OpenInstrumentation/BEK/README.md

Customizable Reporter of Animal Kineses (CRoAK)
