OpenInstrumentation/BEK/Side View.pdf

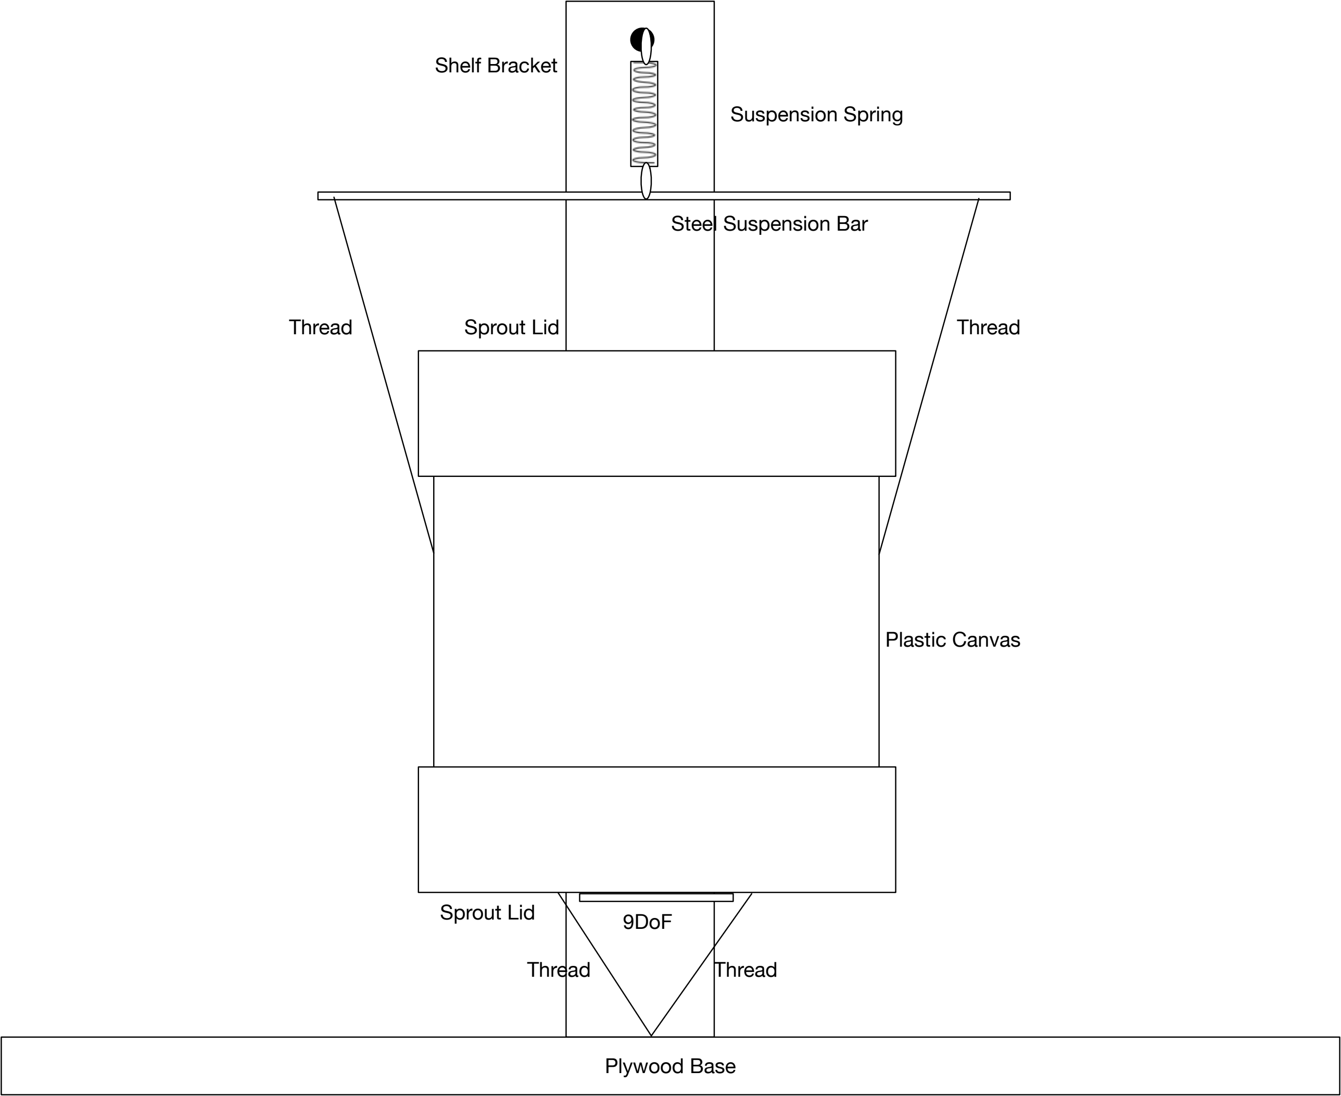
[picture p1: figure]
Sprout Lid; 9DoF; Plastic Canvas; Suspension Spring; Steel Suspension Bar; Thread; Plywood Base; Shelf Bracket
