OpenInstrumentation/BEK/Layout.pdf

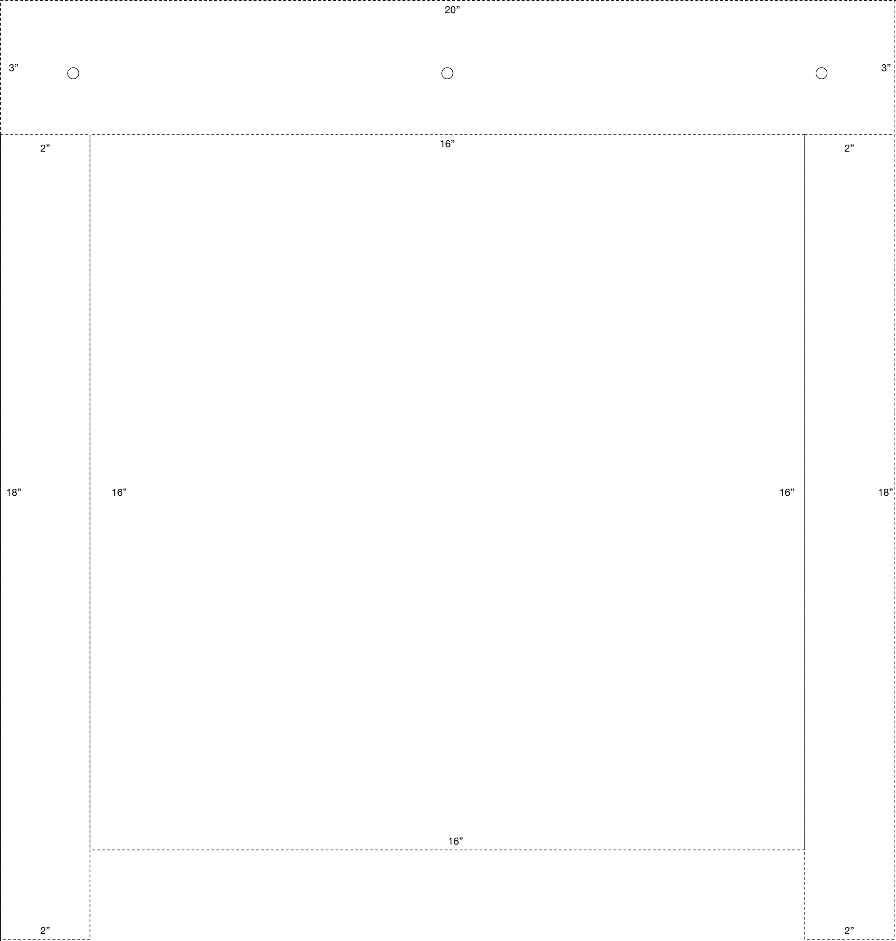
[picture p2: figure]
