OpenInstrumentation/BEK/Top View.pdf

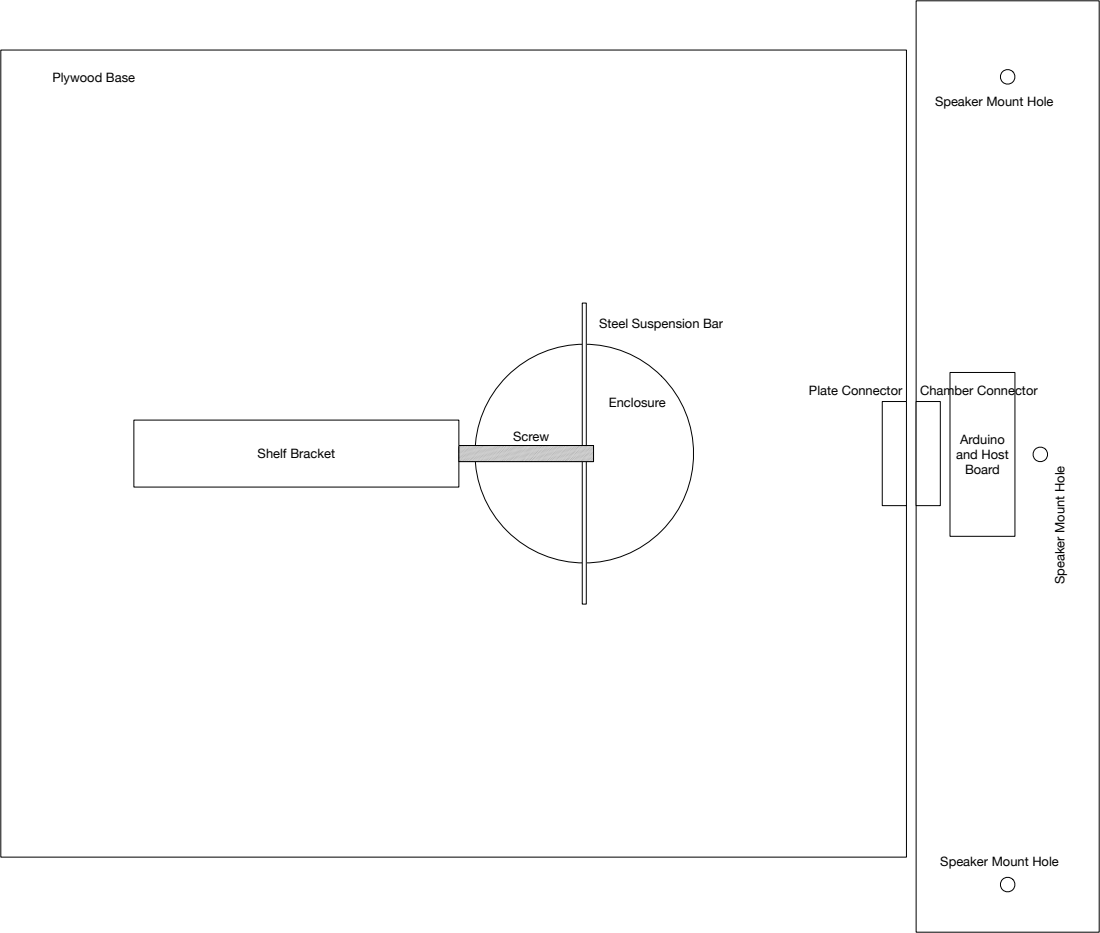
[picture p3: page 1]
Shelf Bracket; Plywood Base; Enclosure; Plate Connector; Arduino and Host Board; Chamber Connector; Screw

Speaker Mount Hole

Steel Suspension Bar
