OpenInstrumentation/BEK/Connections.pdf

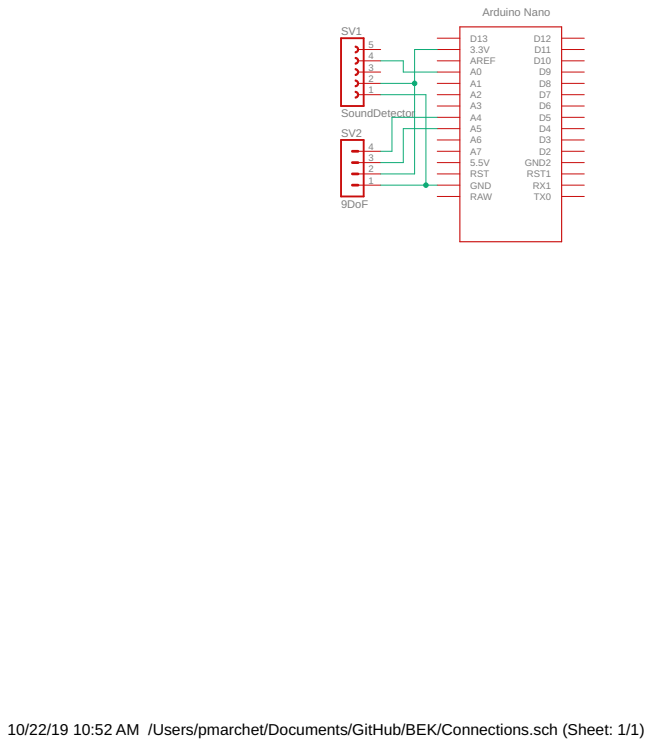
[picture p4: page 1]

10/22/19 10:52 AM /Users/pmarchet/Documents/GitHub/BEK/Connections.sch (Sheet: 1/1)
