OpenInstrumentation/BEK/Connections.sch

## EAGLE design Connections.sch (2019-10-22)

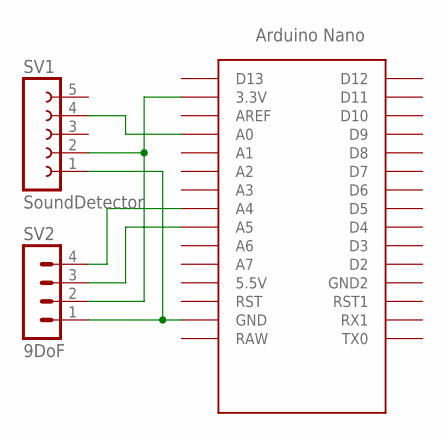
[picture p5: schematic Connections.sch]

Parts:
SV1: SoundDetector; FE05-1
SV2: 9DoF; MA04-1
U$1: NANO

Connections:
unnamed: SV1.1, SV2.1, U$1.GND
unnamed: SV1.2, SV2.2, U$1.3.3V
unnamed: SV2.3, U$1.A5
unnamed: SV2.4, U$1.A4
unnamed: SV1.4, U$1.A0
